Mohamed-Lamara/arm-flex/README.md

# ARM Flex
Github Repository for a Training Assistant Embedded System Project.

*Work in Progress*
