Mohamed-Lamara/arm-flex/CHANGELOG.md

# CHANGELOG

## v0.1 - July 26th

### Added
- UART driver
- USART1 reserved for debugging

### Changed
- Hall sensor moved from PA9 to PA11
- Project Design Document updated
- Software architecture updated

### Fixed
- None.

### Removed
- None.

## v0.2 - August 10th

### Added
- Current firmware source and driver implementation.
- Hardware/KiCad project files.
- Firmware test files.

### Changed
- Synchronized the local ARM Flex project with the GitHub repository.

### Fixed
- None.

### Removed
- None.

## v0.2 - August 12th

### Added
- "EXTI" driver module to the Software Architecture
- "EXTI" section in Module Responsibility in the PDD

### Changed
- Modified the software-architecture.png diagram

### Fixed
- None.

### Removed
- None.
