Mohamed-Lamara/arm-flex/hardware/arm_flex.kicad_pcb

## KiCad design hardware/arm_flex.kicad_pcb (2026-08-10)

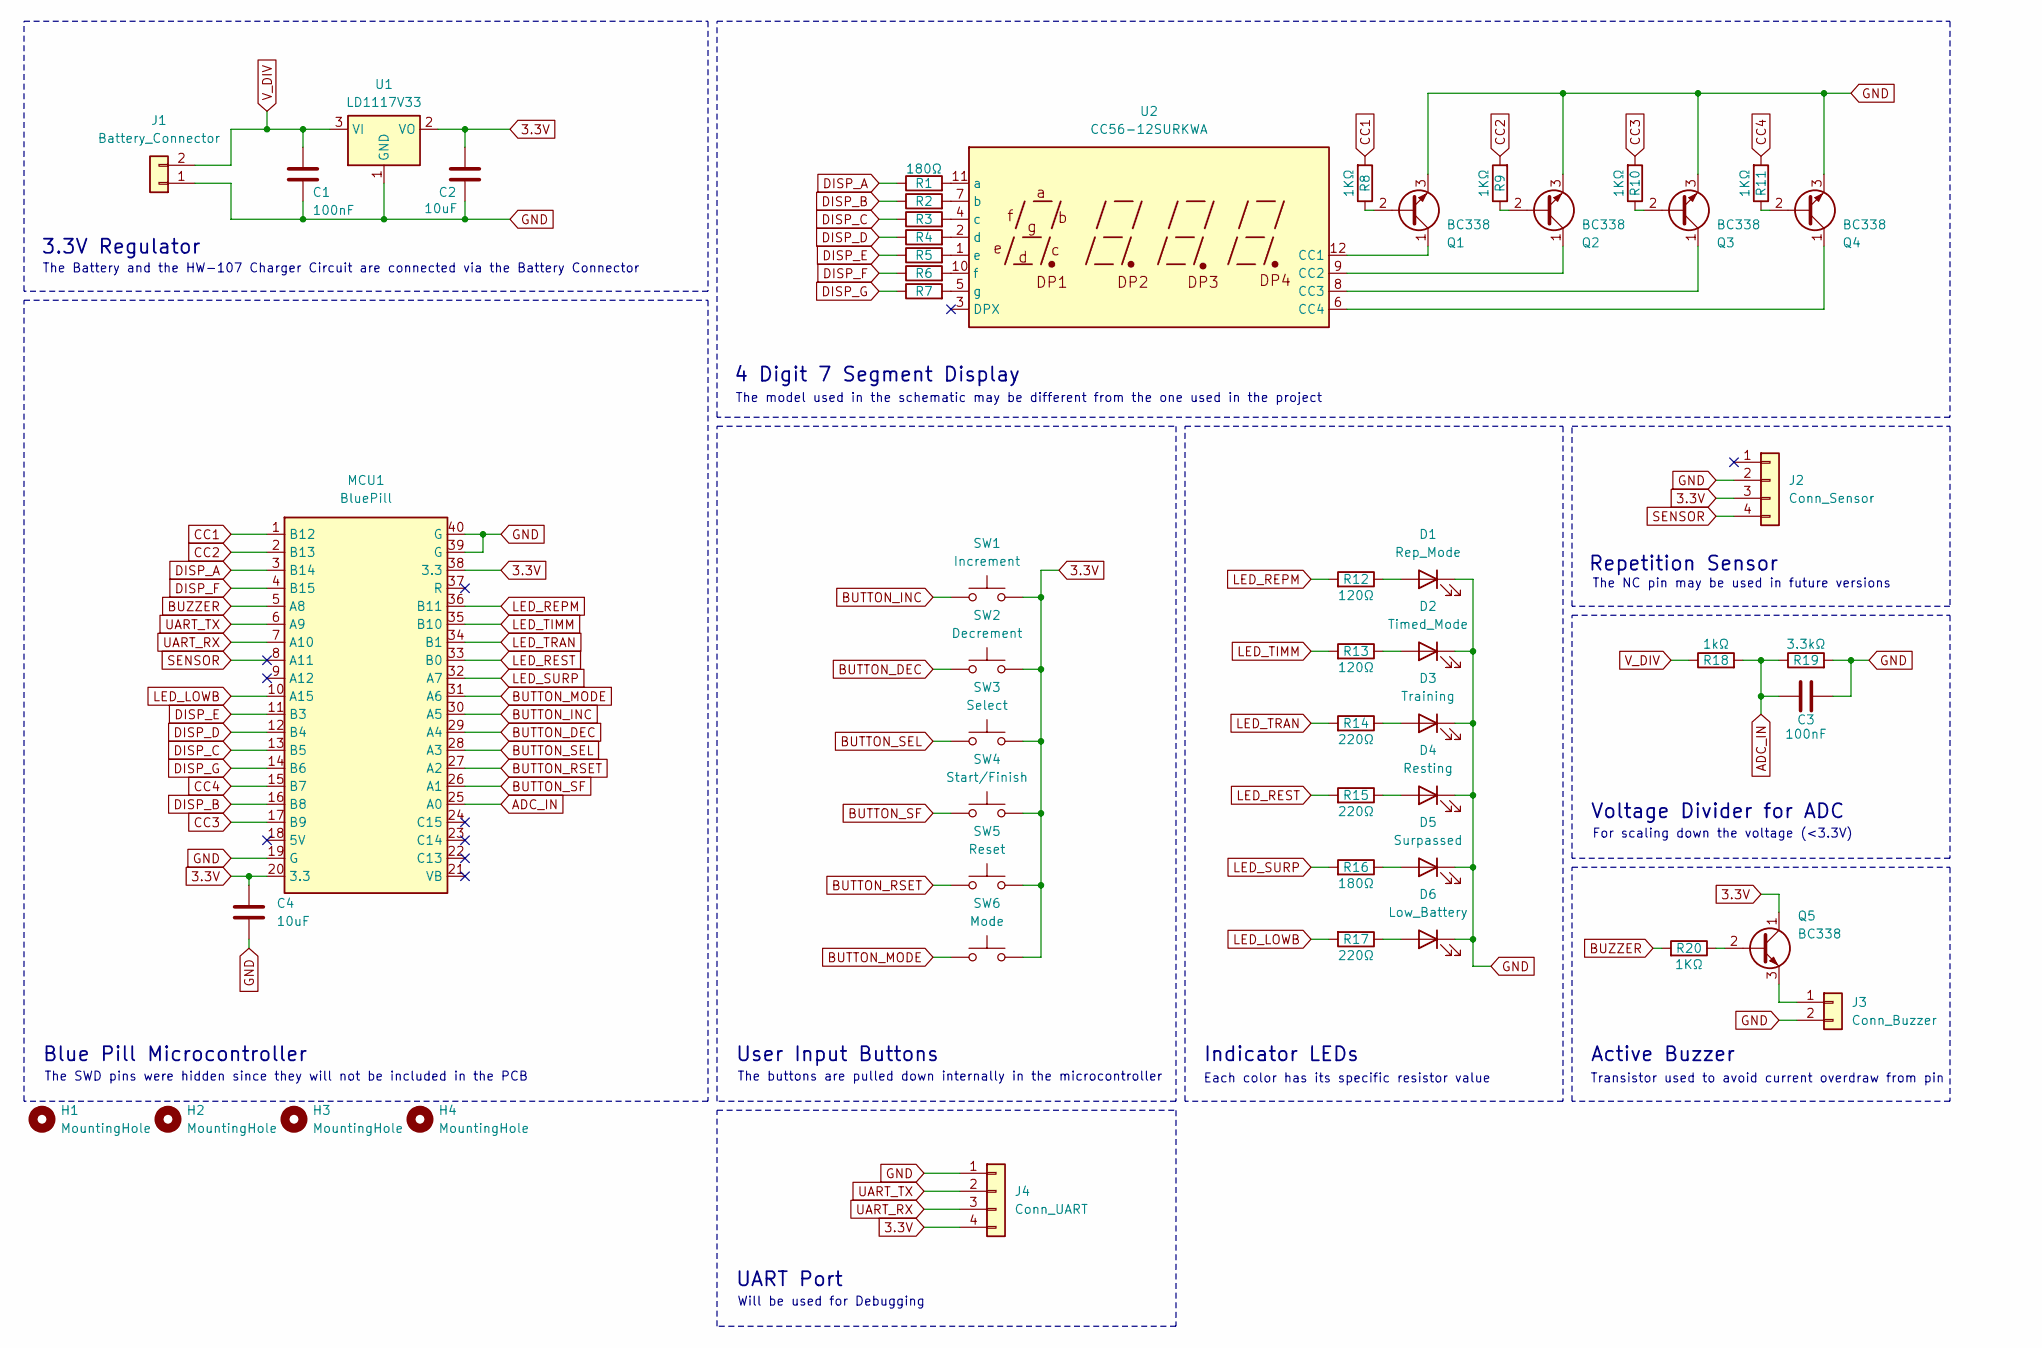
[picture p4: schematic arm_flex.kicad_sch, ARM Flex]

Parts:
C1, C3: 100nF; C_Disc_D3.0mm_W2.0mm_P2.50mm
C2, C4: 10uF; C_Disc_D3.0mm_W2.0mm_P2.50mm
D1: Rep_Mode; LED_D3.0mm
D2: Timed_Mode; LED_D3.0mm
D3: Training; LED_D3.0mm
D4: Resting; LED_D3.0mm
D5: Surpassed; LED_D3.0mm
D6: Low_Battery; LED_D3.0mm
H1, H2, H3, H4: MountingHole; MountingHole_2.2mm_M2_DIN965_Pad
J1: Battery_Connector; JST_EH_B2B-EH-A_1x02_P2.50mm_Vertical
J2: Conn_Sensor; JST_EH_B4B-EH-A_1x04_P2.50mm_Vertical
J3: Conn_Buzzer; PinHeader_1x02_P1.00mm_Vertical
J4: Conn_UART; JST_EH_B4B-EH-A_1x04_P2.50mm_Vertical
MCU1: BluePill
Q1, Q2, Q3, Q4, Q5: BC338; TO-92_Inline
R1, R2, R3, R4, R5, R6, R7: 180Ω; R_Axial_DIN0204_L3.6mm_D1.6mm_P5.08mm_Horizontal
R8, R9, R10, R11: 1KΩ; R_Axial_DIN0204_L3.6mm_D1.6mm_P5.08mm_Horizontal
R12, R13: 120Ω; R_Axial_DIN0204_L3.6mm_D1.6mm_P1.90mm_Vertical
R14, R15, R17: 220Ω; R_Axial_DIN0204_L3.6mm_D1.6mm_P1.90mm_Vertical
R16: 180Ω; R_Axial_DIN0204_L3.6mm_D1.6mm_P1.90mm_Vertical
R18: 1kΩ; R_Axial_DIN0204_L3.6mm_D1.6mm_P5.08mm_Horizontal
R19: 3.3kΩ; R_Axial_DIN0204_L3.6mm_D1.6mm_P5.08mm_Horizontal
R20: 1KΩ; R_Axial_DIN0204_L3.6mm_D1.6mm_P1.90mm_Vertical
SW1: Increment; SW_PUSH-12mm_Wuerth-430476085716
SW2: Decrement; SW_PUSH-12mm_Wuerth-430476085716
SW3: Select; SW_PUSH-12mm_Wuerth-430476085716
SW4: Start/Finish; SW_PUSH-12mm_Wuerth-430476085716
SW5: Reset; SW_PUSH-12mm_Wuerth-430476085716
SW6: Mode; SW_PUSH-12mm_Wuerth-430476085716
U1: LD1117V33; TO-220-3_Horizontal_TabUp
U2: CC56-12SURKWA; CA56-12SURKWA

Connections:
3.3V: C2.1, C4.1, J2.3, J4.4, MCU1.20 (3.3), MCU1.38 (3.3), Q5.1 (C), SW1.2, SW2.2, SW3.2, SW4.2, SW5.2, SW6.2, U1.2 (VO); also elsewhere on the board
ADC_IN: C3.1, MCU1.25 (A0), R18.2, R19.1
BUTTON_DEC: MCU1.29 (A4), SW2.1
BUTTON_INC: MCU1.30 (A5), SW1.1
BUTTON_MODE: MCU1.31 (A6), SW6.1
BUTTON_RSET: MCU1.27 (A2), SW5.1
BUTTON_SEL: MCU1.28 (A3), SW3.1
BUTTON_SF: MCU1.26 (A1), SW4.1
BUZZER: MCU1.5 (A8), R20.2
CC1: MCU1.1 (B12), R8.2
CC2: MCU1.2 (B13), R9.2
CC3: MCU1.17 (B9), R10.2
CC4: MCU1.15 (B7), R11.2
DISP_A: MCU1.3 (B14), R1.1
DISP_B: MCU1.16 (B8), R2.1
DISP_C: MCU1.13 (B5), R3.1
DISP_D: MCU1.12 (B4), R4.1
DISP_E: MCU1.11 (B3), R5.1
DISP_F: MCU1.4 (B15), R6.1
DISP_G: MCU1.14 (B6), R7.1
GND: C1.2, C2.2, C3.2, C4.2, D1.1 (K), D2.1 (K), D3.1 (K), D4.1 (K), D5.1 (K), D6.1 (K), J1.1, J2.2, J3.2, J4.1, MCU1.19 (G), MCU1.39 (G), MCU1.40 (G), Q1.3 (E), Q2.3 (E), Q3.3 (E), Q4.3 (E), R19.2, U1.1 (GND); also elsewhere on the board
LED_LOWB: MCU1.10 (A15), R17.2
LED_REPM: MCU1.36 (B11), R12.2
LED_REST: MCU1.33 (B0), R15.2
LED_SURP: MCU1.32 (A7), R16.2
LED_TIMM: MCU1.35 (B10), R13.2
LED_TRAN: MCU1.34 (B1), R14.2
unnamed: D1.2 (A), R12.1
unnamed: D2.2 (A), R13.1
unnamed: D3.2 (A), R14.1
unnamed: D4.2 (A), R15.1
unnamed: D5.2 (A), R16.1
unnamed: D6.2 (A), R17.1
unnamed: J3.1, Q5.3 (E)
unnamed: Q1.2 (B), R8.1
unnamed: Q1.1 (C), U2.12 (CC1)
unnamed: Q2.2 (B), R9.1
unnamed: Q2.1 (C), U2.9 (CC2)
unnamed: Q3.2 (B), R10.1
unnamed: Q3.1 (C), U2.8 (CC3)
unnamed: Q4.2 (B), R11.1
unnamed: Q4.1 (C), U2.6 (CC4)
unnamed: Q5.2 (B), R20.1
unnamed: R1.2, U2.11 (a)
unnamed: R2.2, U2.7 (b)
unnamed: R3.2, U2.4 (c)
unnamed: R4.2, U2.2 (d)
unnamed: R5.2, U2.1 (e)
unnamed: R6.2, U2.10 (f)
unnamed: R7.2, U2.5 (g)
SENSOR: J2.4, MCU1.8 (A11)
UART_RX: J4.3, MCU1.7 (A10); also elsewhere on the board
UART_TX: J4.2, MCU1.6 (A9); also elsewhere on the board
V_DIV: C1.1, J1.2, R18.1, U1.3 (VI)

Notes on the sheet:
The Battery and the HW-107 Charger Circuit are connected via the Battery Connector
UART Port
Active Buzzer
The NC pin may be used in future versions
Indicator LEDs
The buttons are pulled down internally in the microcontroller
Repetition Sensor
Voltage Divider for ADC
4 Digit 7 Segment Display
Will be used for Debugging
Each color has its specific resistor value
The model used in the schematic may be different from the one used in the project
For scaling down the voltage (<3.3V)
3.3V Regulator
The SWD pins were hidden since they will not be included in the PCB
User Input Buttons
Transistor used to avoid current overdraw from pin
Blue Pill Microcontroller

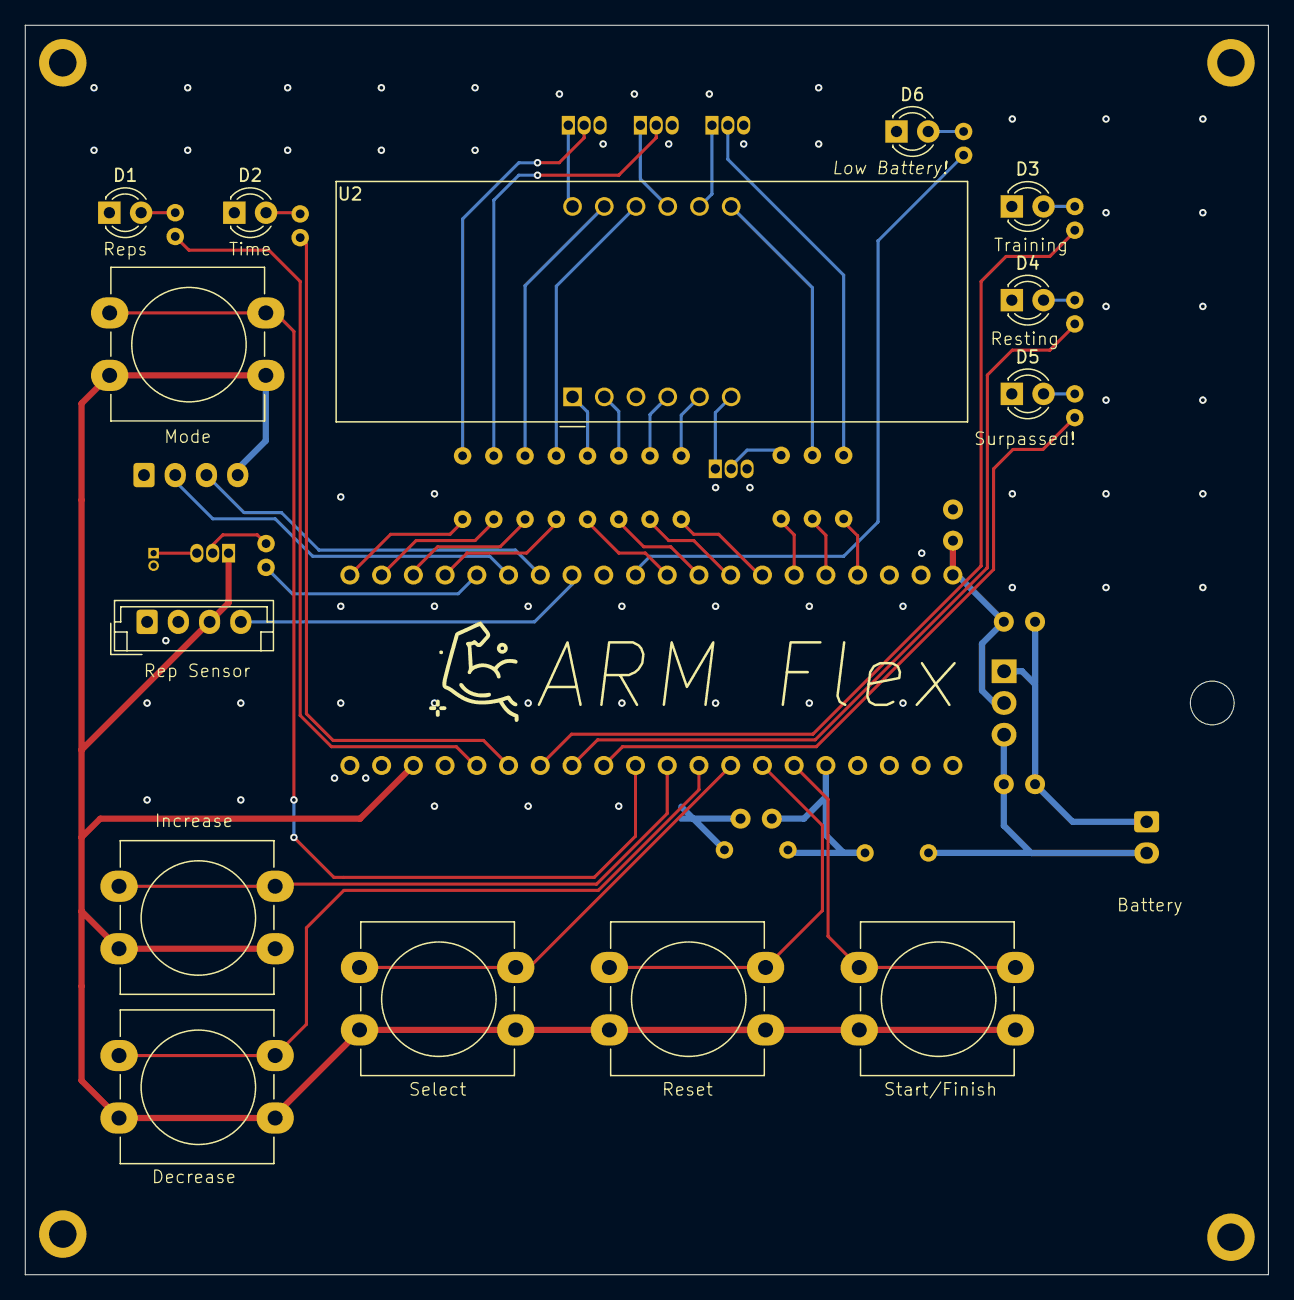
[picture p5: board arm_flex.kicad_pcb from above]

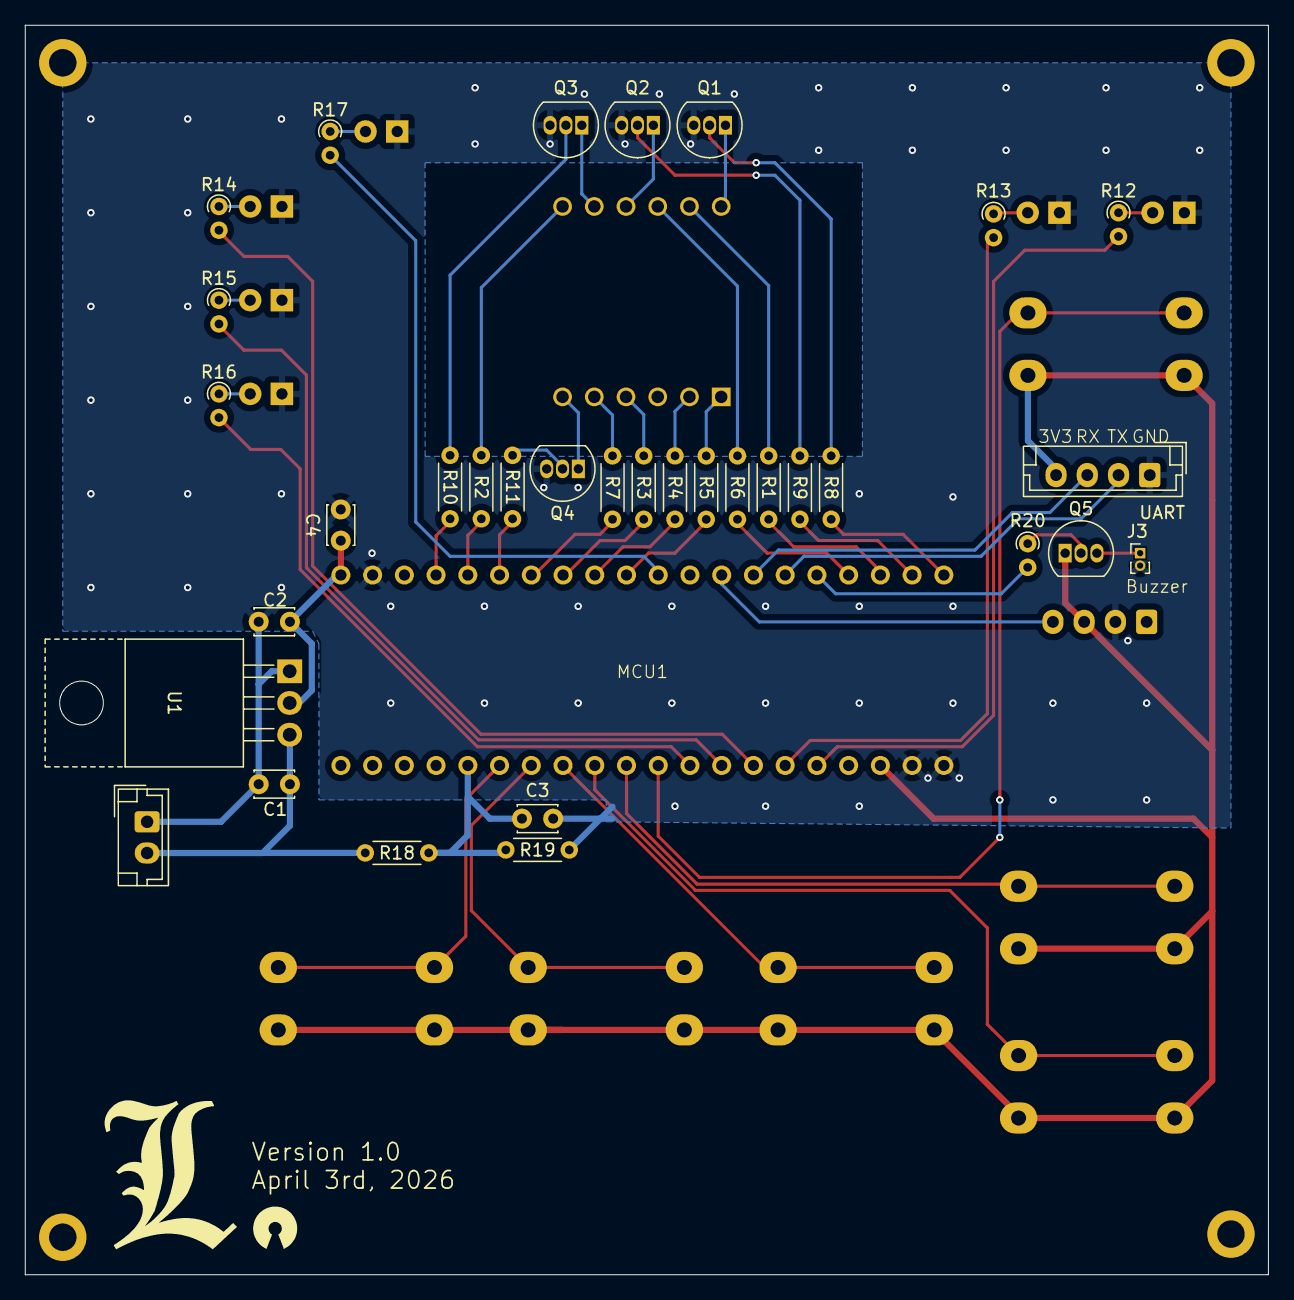
[picture p6: board arm_flex.kicad_pcb from below]

Board: 2 copper layers, 99.5 x 100.0 mm, 52 parts (34 on the bottom side), 54 nets.

Other parts of the board:
UART: Conn_UART; JST_EH_B4B-EH-A_1x04_P2.50mm_Vertical

Their connections:
3.3V: UART.4; also elsewhere on the board
GND: UART.1; also elsewhere on the board
UART_RX: UART.3; also elsewhere on the board
UART_TX: UART.2; also elsewhere on the board
