Mohamed-Lamara/arm-flex/(commit log)

2026-08-10 Update Software Architecture
    Add UART module to the drivers layer
2026-08-10 Update Project Design Document
    - Add UART in Module Responsibility section
    - Fix minor inconsistencies
2026-08-10 Update project structure and files
    [arm_flex.kicad_pcb, arm_flex.kicad_sch]
2026-08-11 Implement User Input test file and minor fixes Changes to be committed: new file: firmware/test/user_input/test_main.c modified: firmware/.gitignore deleted: firmware/app/readme.md deleted: firmware/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
    [test_main.c]
2026-08-11 Implement "Feedback" application module and its test file. Another fixes include: fix "User input" and "Indicator" test files
    [feedback.c, test_main.c]
2026-08-12 Implement "Battery Monitor" application module and its test file
2026-08-12 Add new driver module and Update Documentation
2026-08-12 Implement "External Interrupt" Driver module
2026-08-12 Implement "Sensor" Application Module and its test file
2026-08-13 Update "Display" driver
    Added functionality of displaying minus "-" character for time displaying
    purposes.
2026-08-13 Minor Fix for "Display" Driver
    [display.c]
